dy0908ky/EMG-BioFeedback-rehabilitation-game/(commit log)

2026-08-31 add prototype images
2026-08-31 Create circuit folder
